aleghezzo/PCB-SiP-OSD3358-SM/README.txt

# 4 Layer PCB Based on SiP OSD3358-SM.
## Power Source - SMPS de 12/24V a 5V.
## LDO 3.3V.
## 2 USB Connectors: Host A y Device Micro B.
## MicroSD
