aleghezzo/PCB-SiP-OSD3358-SM/3D models/ST-TF-003A--3DModel-STEP-56544.STEP

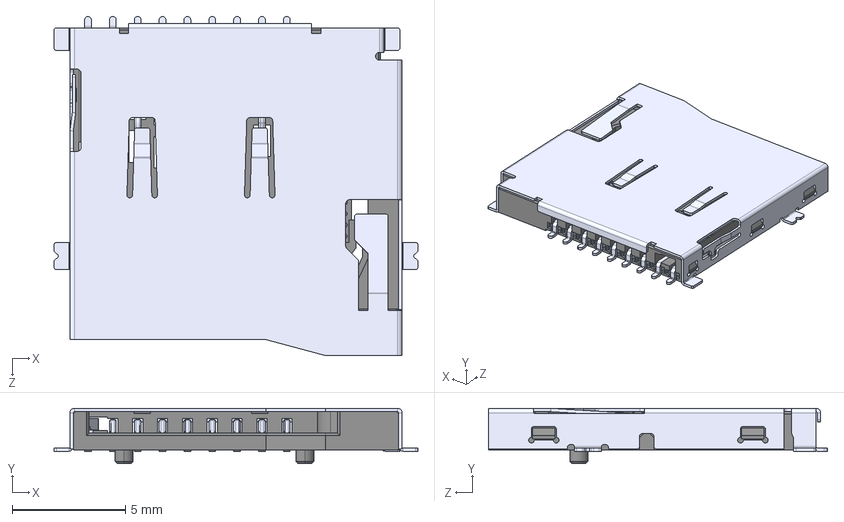
[picture p1: CAD file, 2020-08-16]
3D models/ST-TF-003A--3DModel-STEP-56544.STEP
16.1 x 2.45 x 15.0 mm
