aleghezzo/PCB-SiP-OSD3358-SM/3D models/microSD.stp

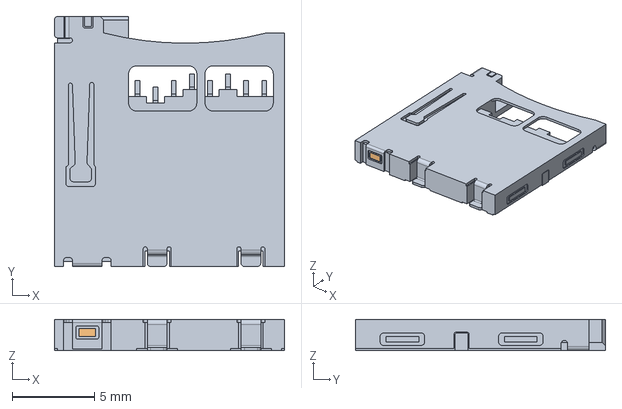
[picture p2: CAD file, 2020-08-06]
3D models/microSD.stp
14.0 x 15.2 x 1.90 mm
