aleghezzo/PCB-SiP-OSD3358-SM/3D models/CircuitWorks-FUSE.step

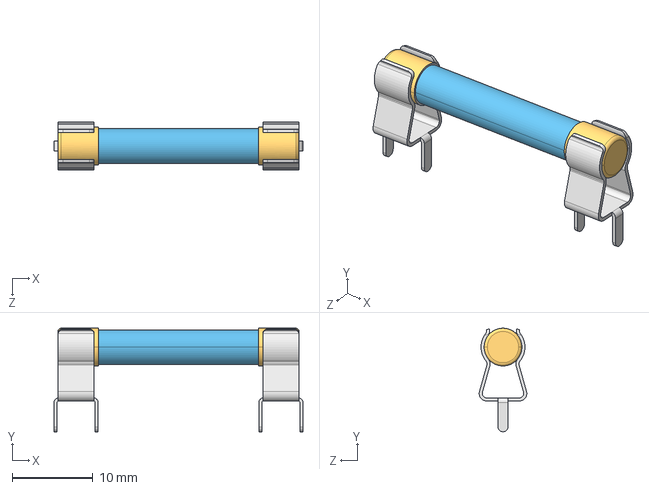
[picture p3: CAD file, 2020-08-06]
3D models/CircuitWorks-FUSE.step
30.9 x 12.8 x 5.90 mm
