aleghezzo/PCB-SiP-OSD3358-SM/3D models/0679H0250-01--3DModel-STEP-56544.STEP

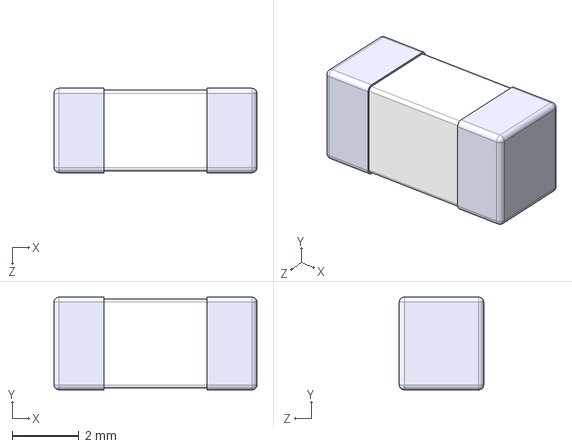
[picture p4: CAD file, 2020-08-16]
3D models/0679H0250-01--3DModel-STEP-56544.STEP
6.10 x 2.79 x 2.54 mm
