aleghezzo/PCB-SiP-OSD3358-SM/doc/pcbproyecto.pdf

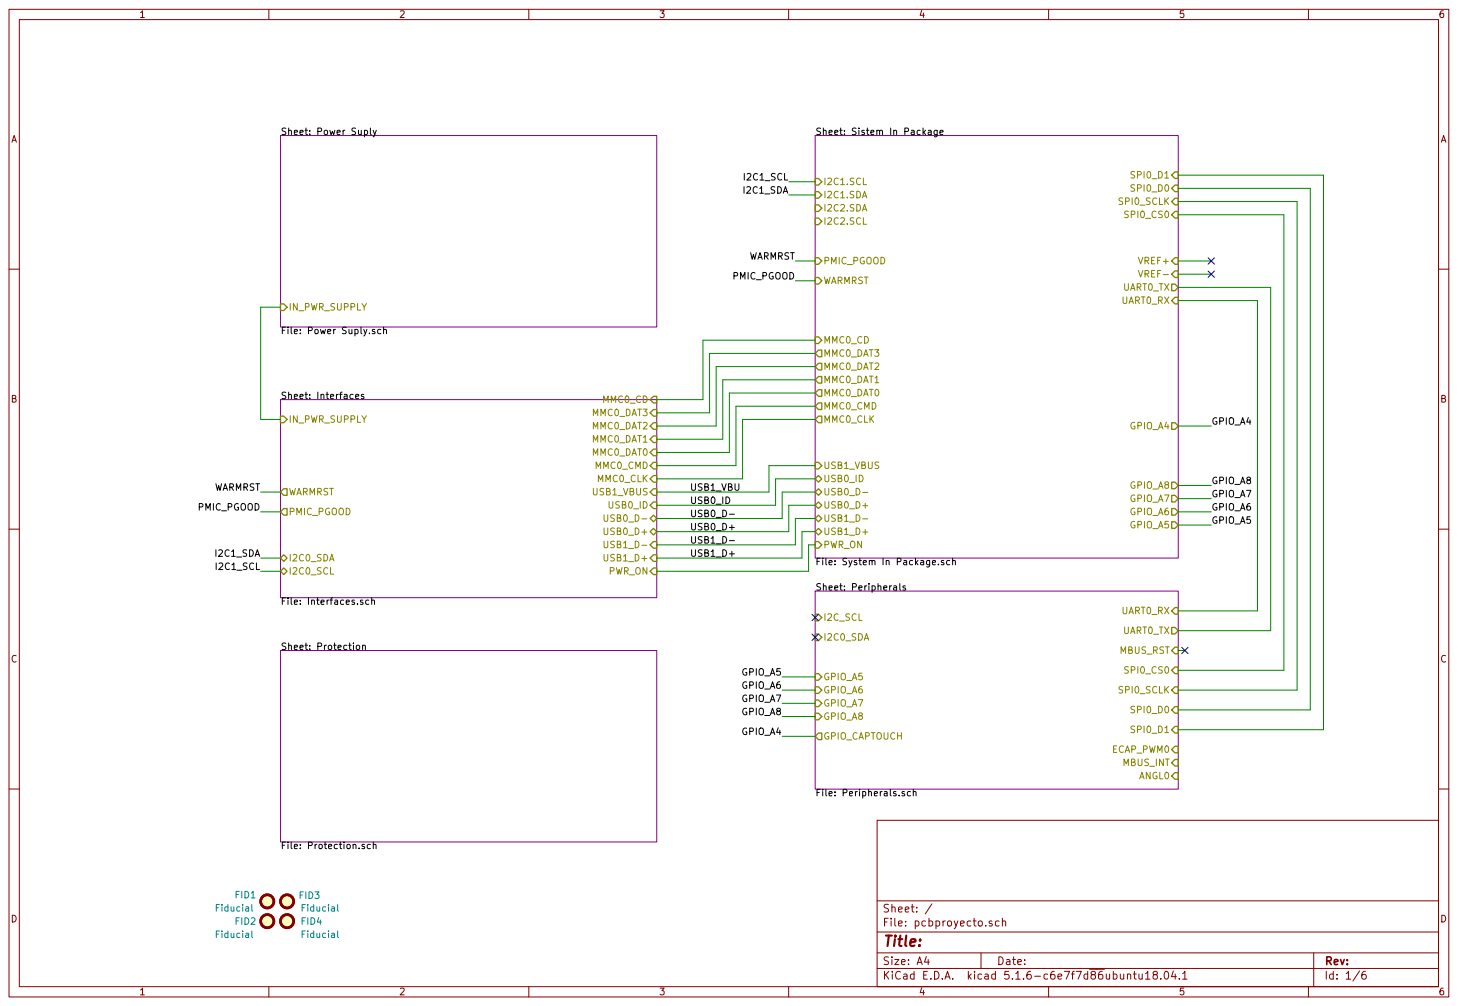
[picture p5: page 1]

Sheet: Sistem In Package
I2C2.SCL USB1_D- USB1_D+ USB0_D- USB0_D+ USB0_ID MMC0_CLK MMC0_DAT0 MMC0_DAT1 MMC0_DAT2 MMC0_DAT3 MMC0_CMD

File: Power Suply.sch

File: pcbproyecto.sch Sheet: / Sheet: Protection File: Protection.sch

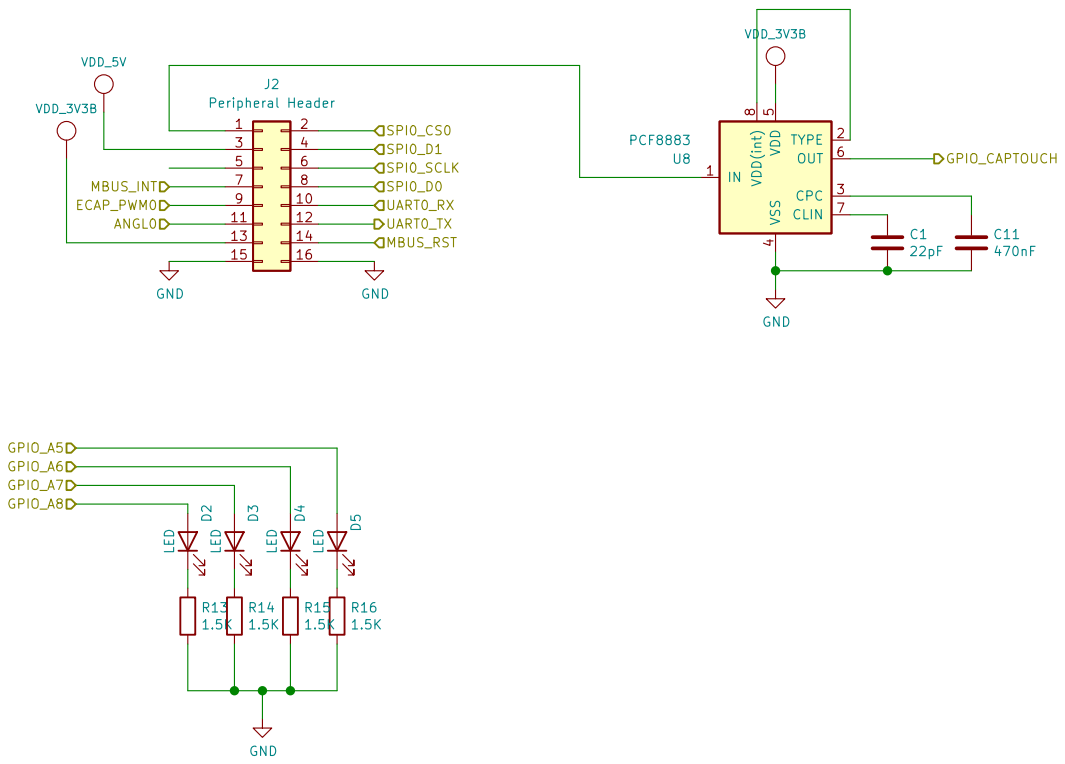
[picture p6: page 2]

5 OUT 6 CLIN 7 VDD(int) 8 U8 PCF8883

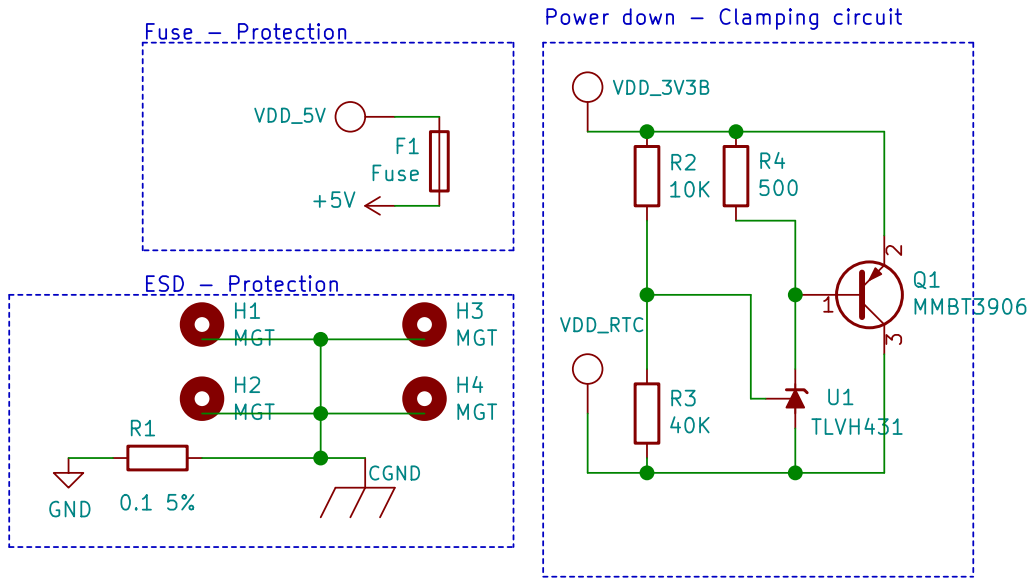
[picture p7: page 3]

2 3 Q1 H1 MMBT3906 MGT H3 MGT H2 MGT H4 MGT CGND R1

Id: 3/6 Title: File: Protection.sch Sheet: /Protection/

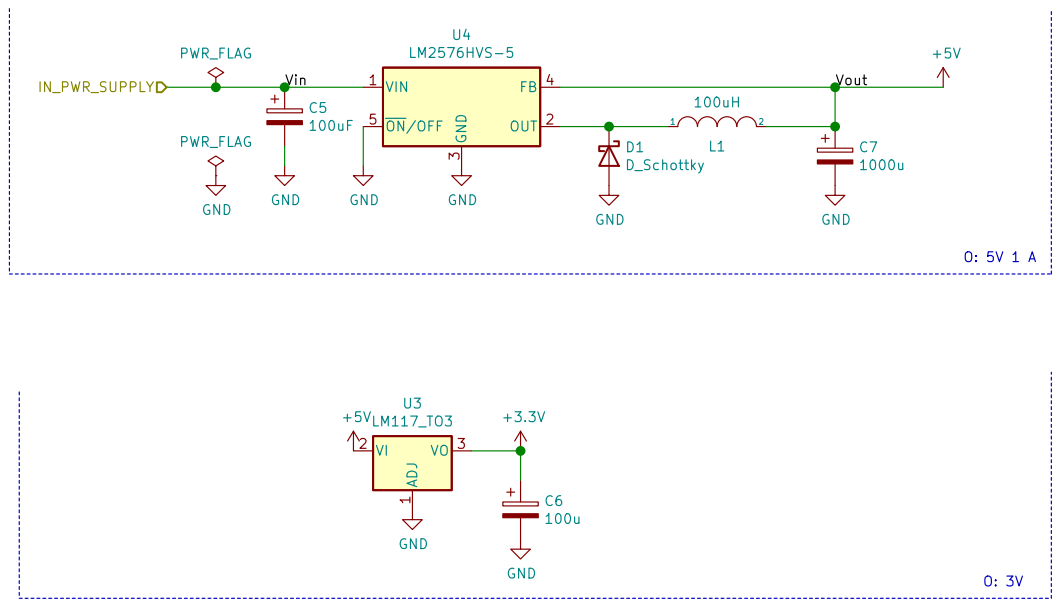
[picture p8: page 4]

Sheet: /Power Suply/
File: Power Suply.sch
Id: 4/6 Title:

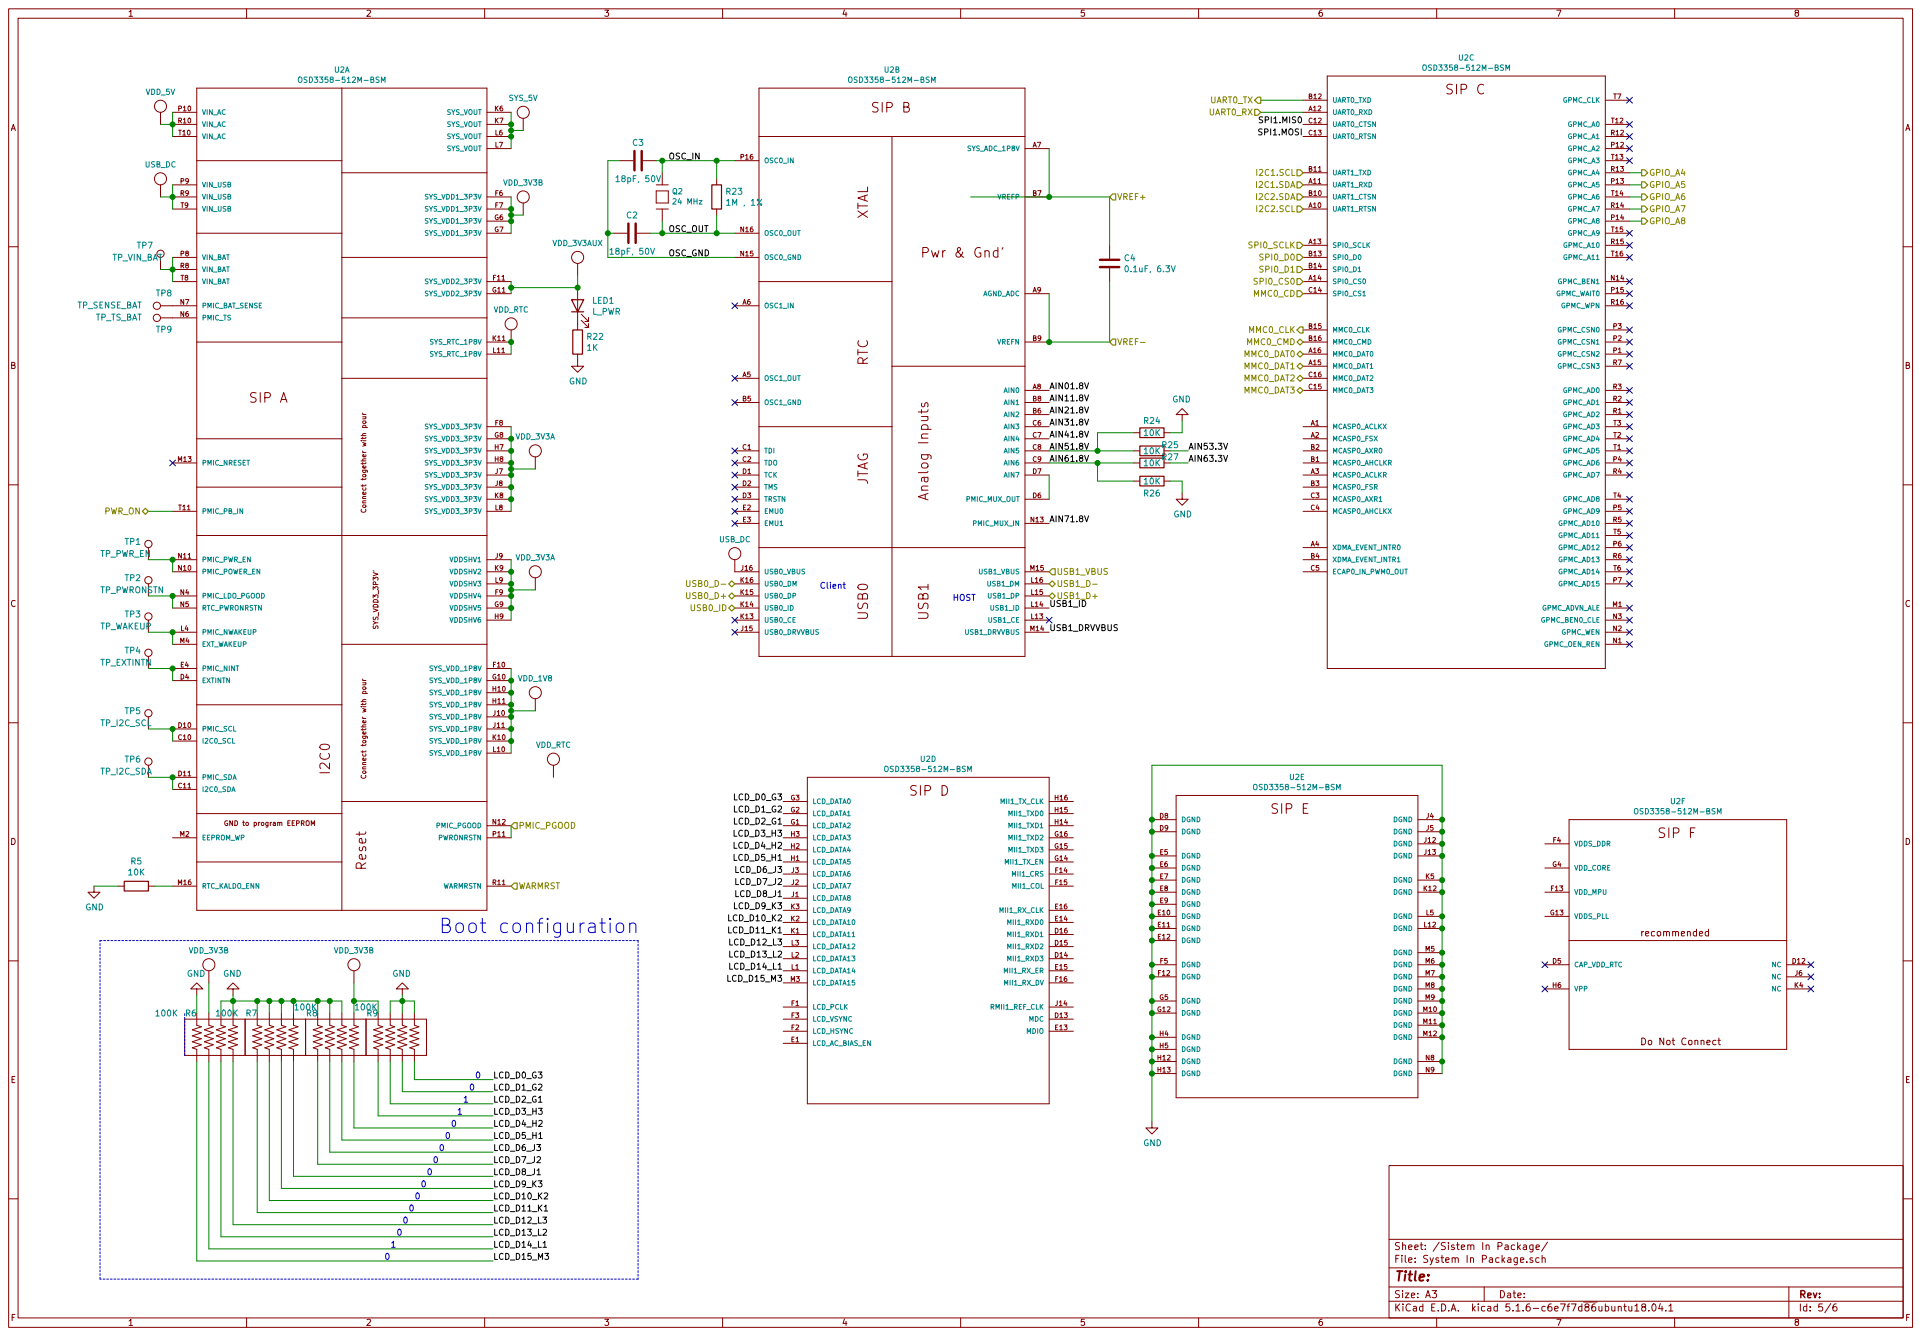
[picture p9: page 5]

Do Not Connect recommended SIP F

Sheet: /Sistem In Package/ GND

File: System In Package.sch
Id: 5/6 Title:

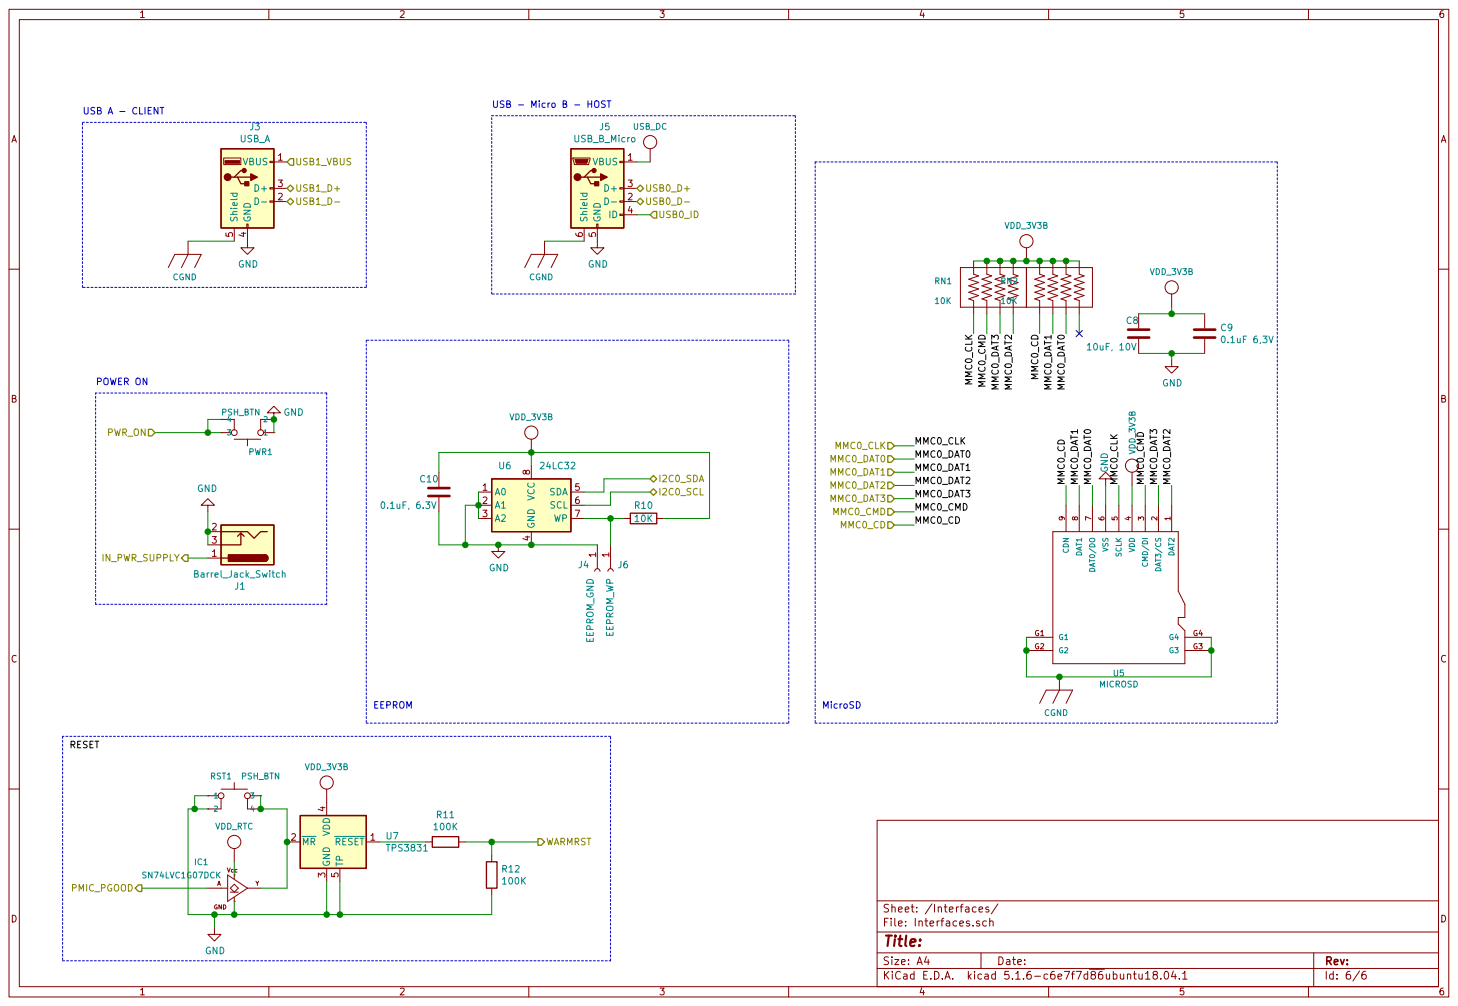
[picture p10: page 6]

USB A - CLIENT POWER ON
J1 Barrel_Jack_Switch CGND

4 SDA 5 SCL 6 WP 7 VCC

Id: 6/6 Title: File: Interfaces.sch Sheet: /Interfaces/
