aleghezzo/PCB-SiP-OSD3358-SM/doc/pcbproyecto-B_Cu.pdf

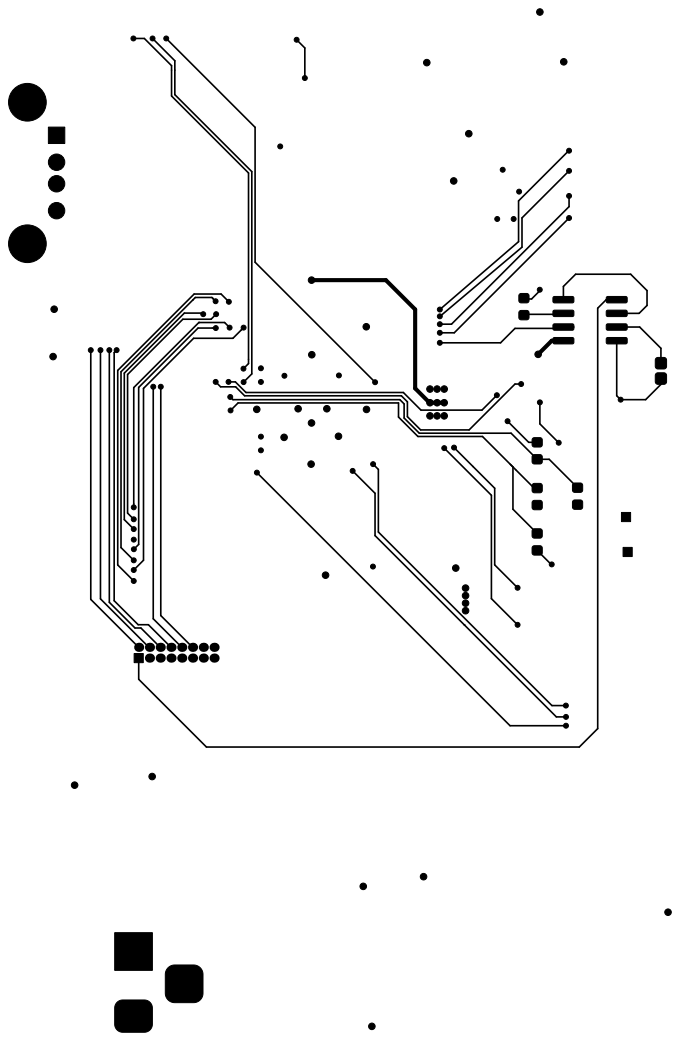
[picture p11: page 1]
