aleghezzo/PCB-SiP-OSD3358-SM/doc/pcbproyecto-B_Mask.pdf

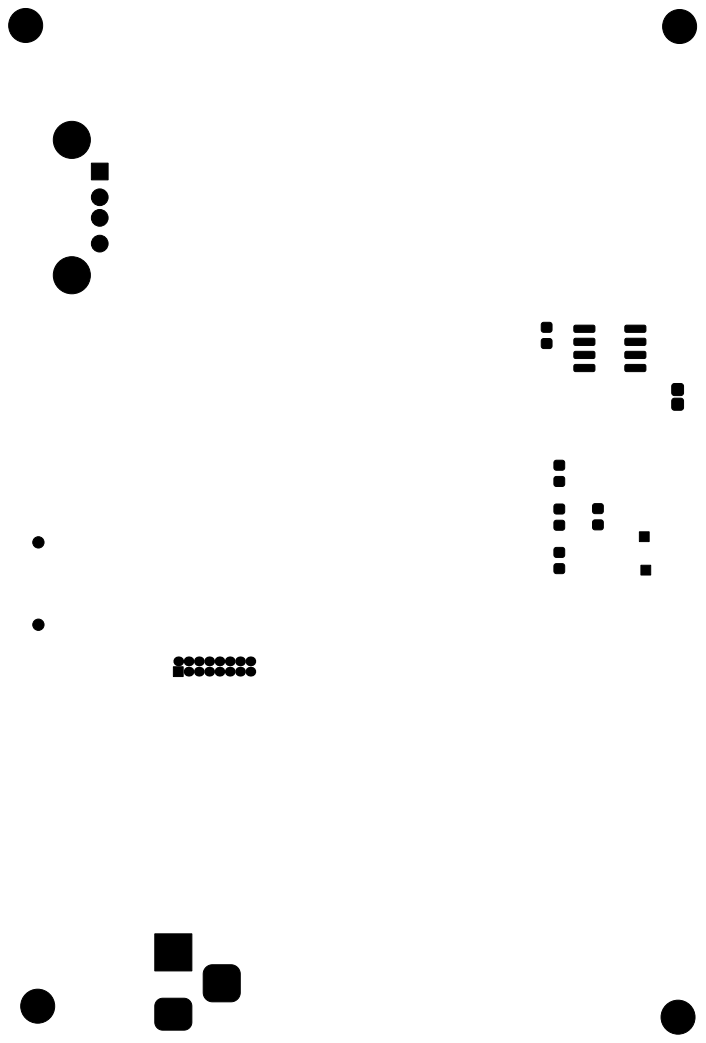
[picture p12: page 1]
