aleghezzo/PCB-SiP-OSD3358-SM/doc/pcbproyecto-B_Paste.pdf

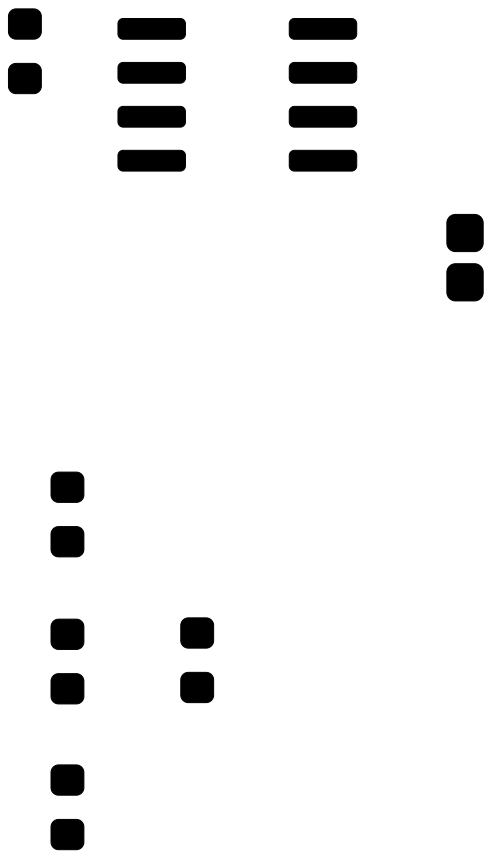
[picture p13: page 1]
