aleghezzo/PCB-SiP-OSD3358-SM/doc/pcbproyecto-B_SilkS.pdf

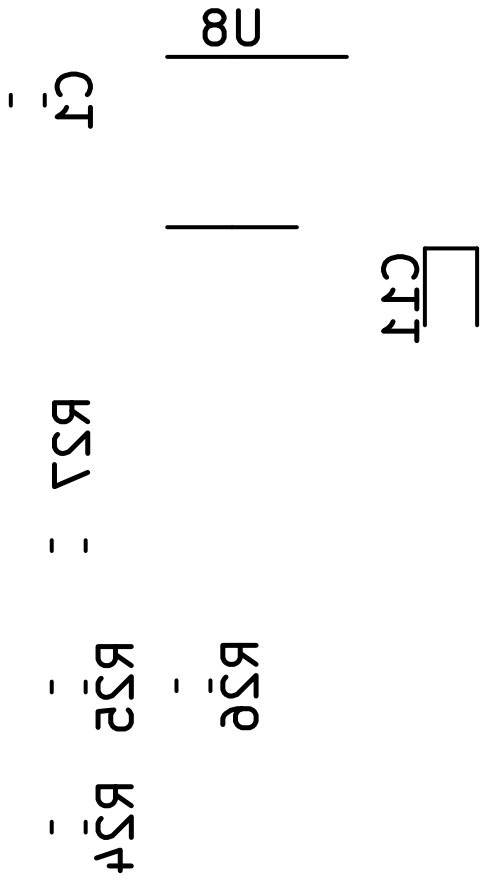
[picture p14: page 1]
