aleghezzo/PCB-SiP-OSD3358-SM/doc/pcbproyecto-Edge_Cuts.pdf

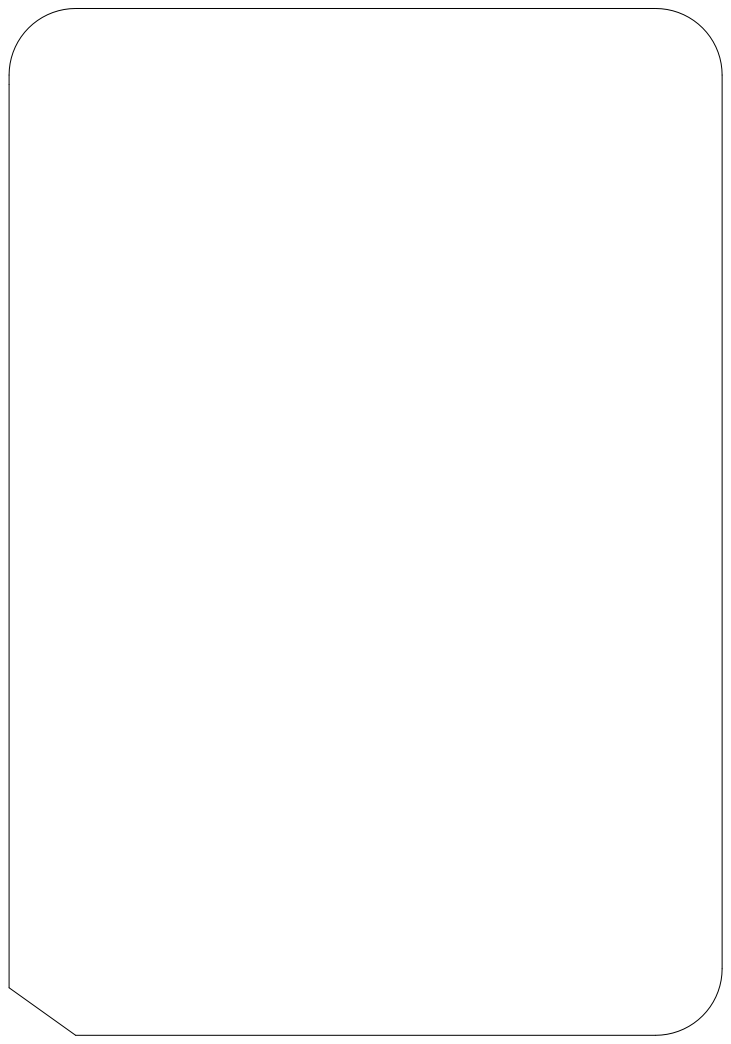
[picture p15: page 1]
