aleghezzo/PCB-SiP-OSD3358-SM/doc/pcbproyecto-F_Cu.pdf

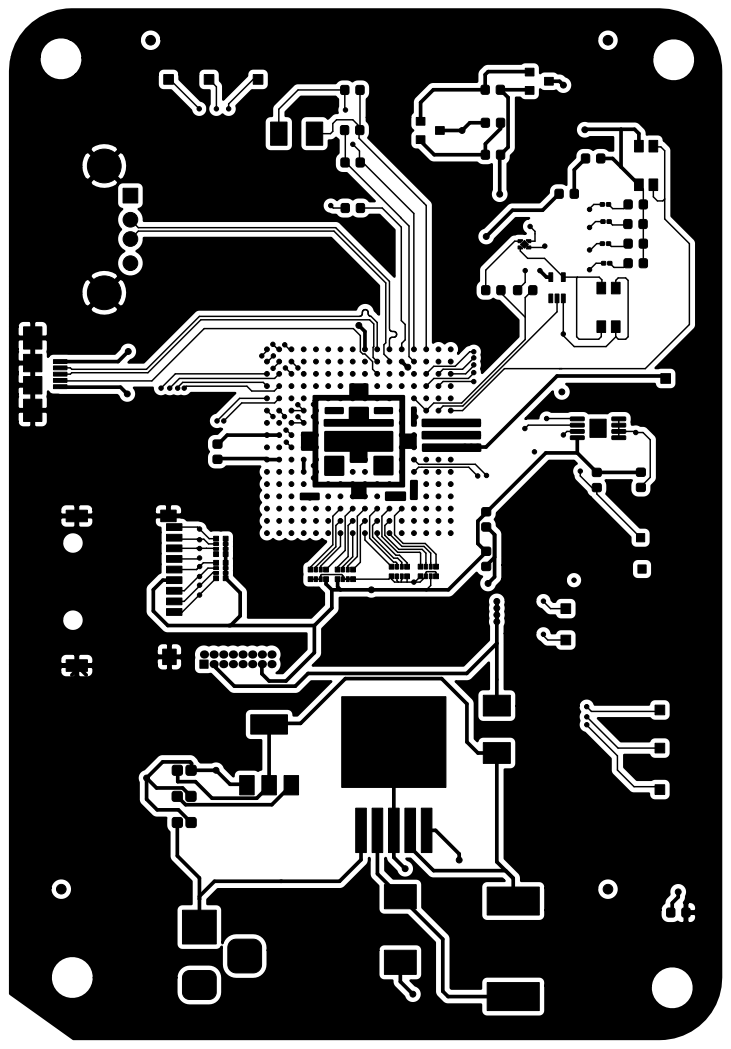
[picture p16: page 1]
