aleghezzo/PCB-SiP-OSD3358-SM/doc/pcbproyecto-F_Mask.pdf

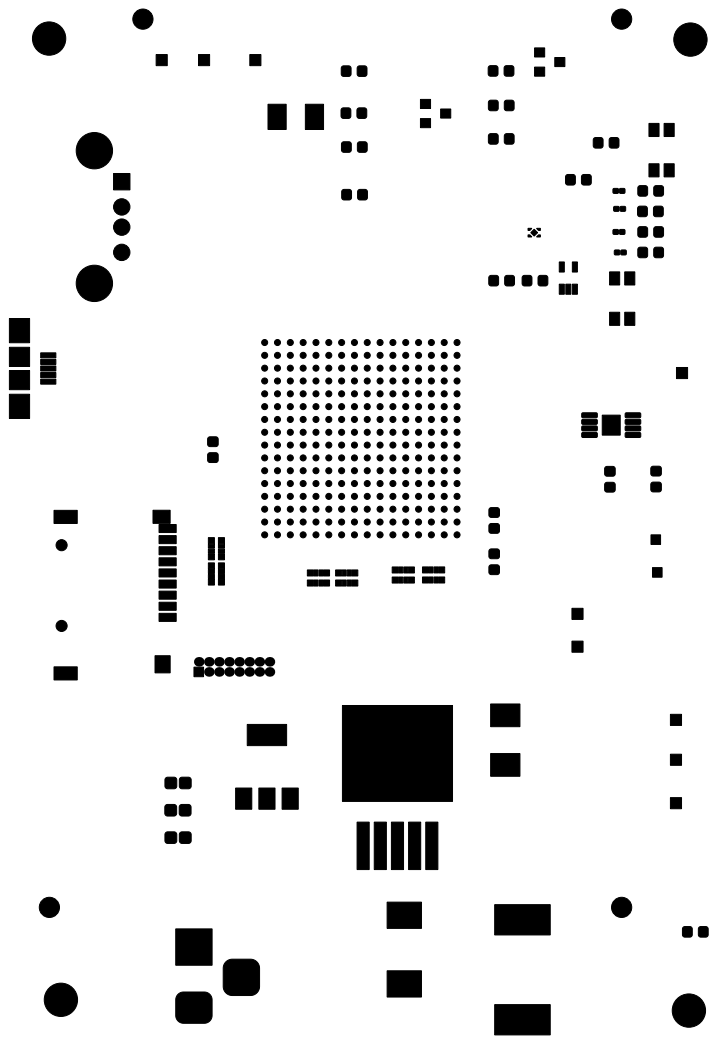
[picture p17: page 1]
