aleghezzo/PCB-SiP-OSD3358-SM/doc/pcbproyecto-F_Paste.pdf

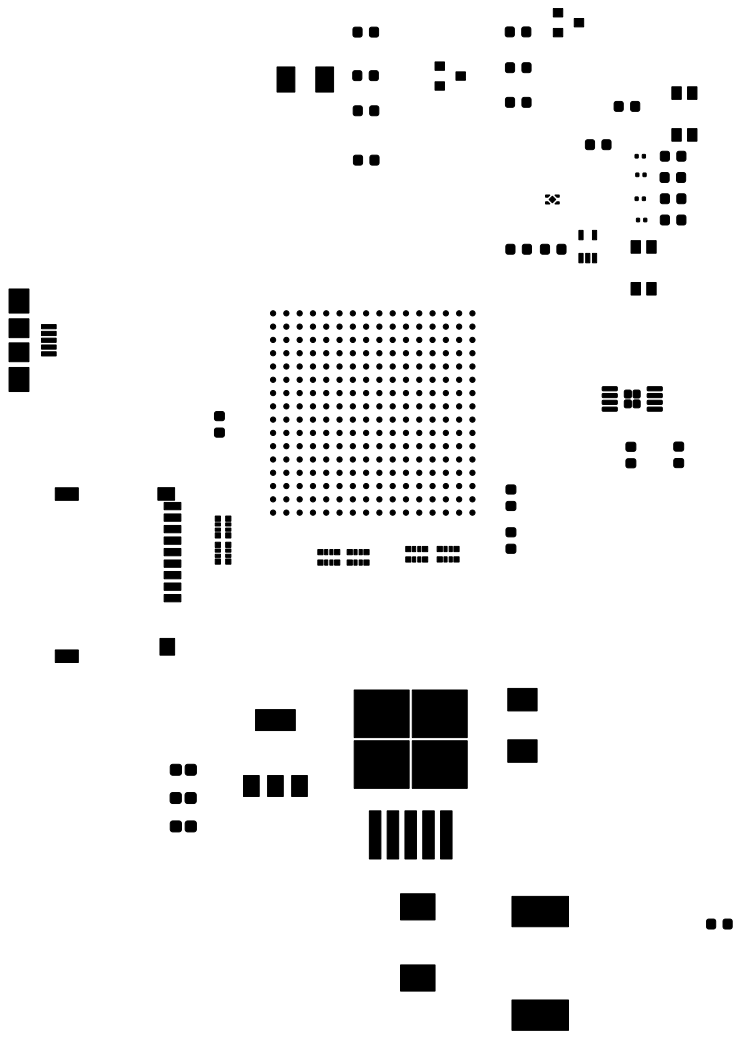
[picture p18: page 1]
