aleghezzo/PCB-SiP-OSD3358-SM/doc/pcbproyecto-F_SilkS.pdf

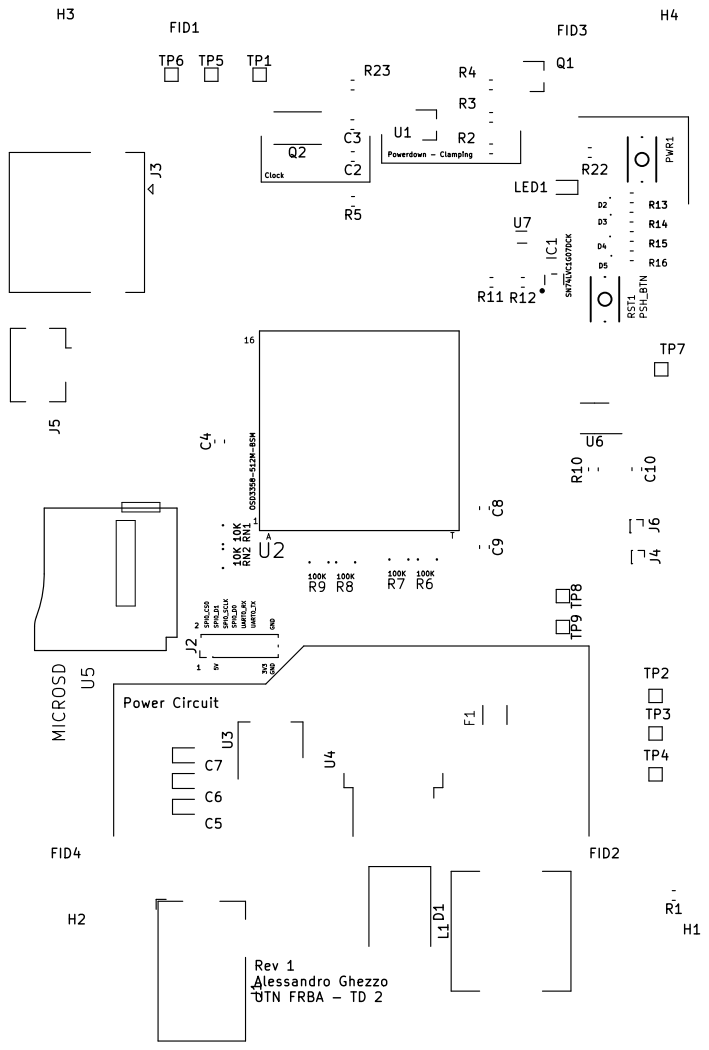
[picture p19: page 1]

Clock Rev 1 Alessandro Ghezzo UTN FRBA - TD 2
