aleghezzo/PCB-SiP-OSD3358-SM/doc/pcbproyecto-GND_Cu.pdf

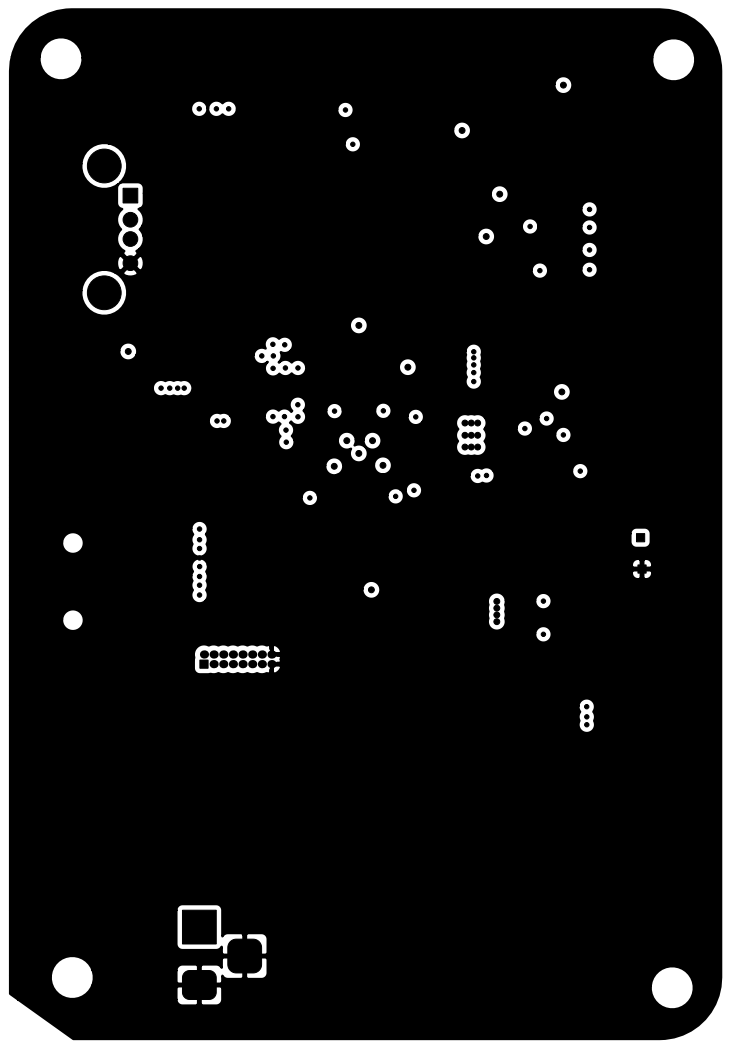
[picture p20: page 1]
