aleghezzo/PCB-SiP-OSD3358-SM/doc/pcbproyecto-Power_Cu.pdf

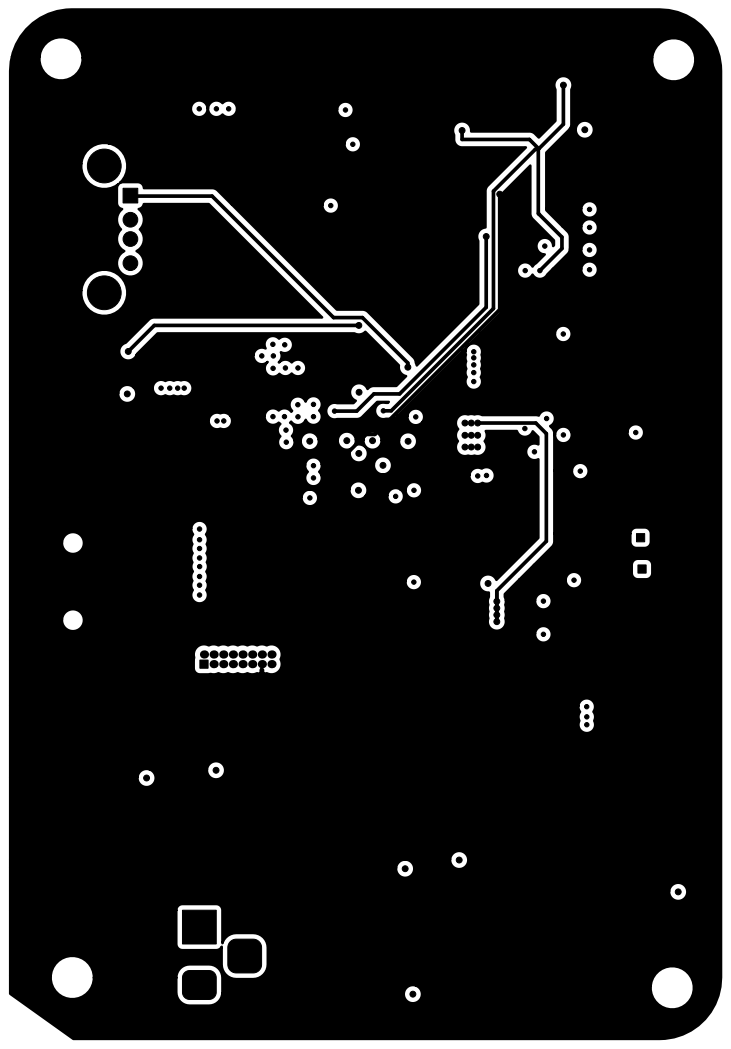
[picture p21: page 1]
