aleghezzo/PCB-SiP-OSD3358-SM/pcbproyecto.kicad_pcb

## KiCad design pcbproyecto.kicad_pcb (2020-08-16)

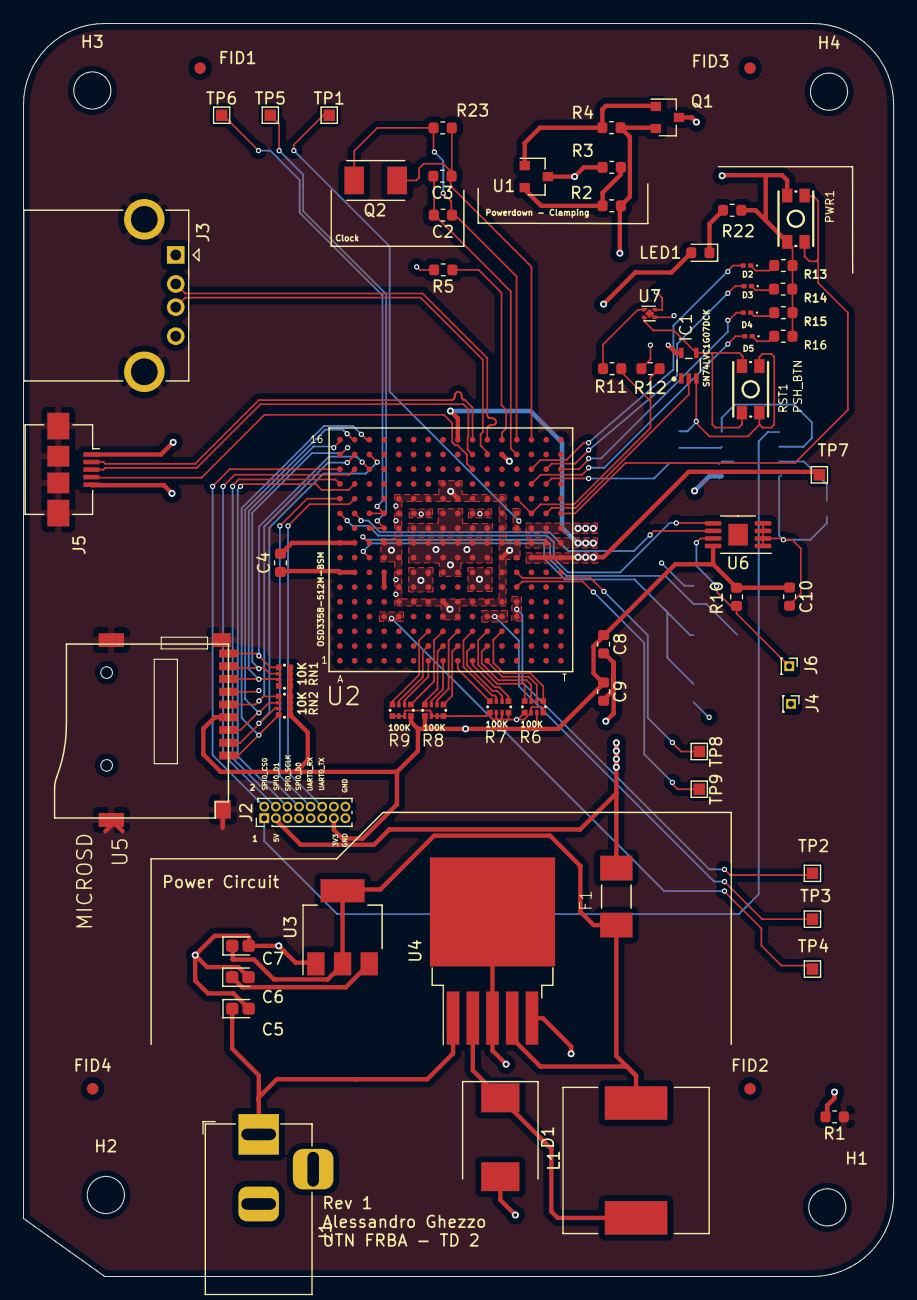
[picture p22: board pcbproyecto.kicad_pcb from above]

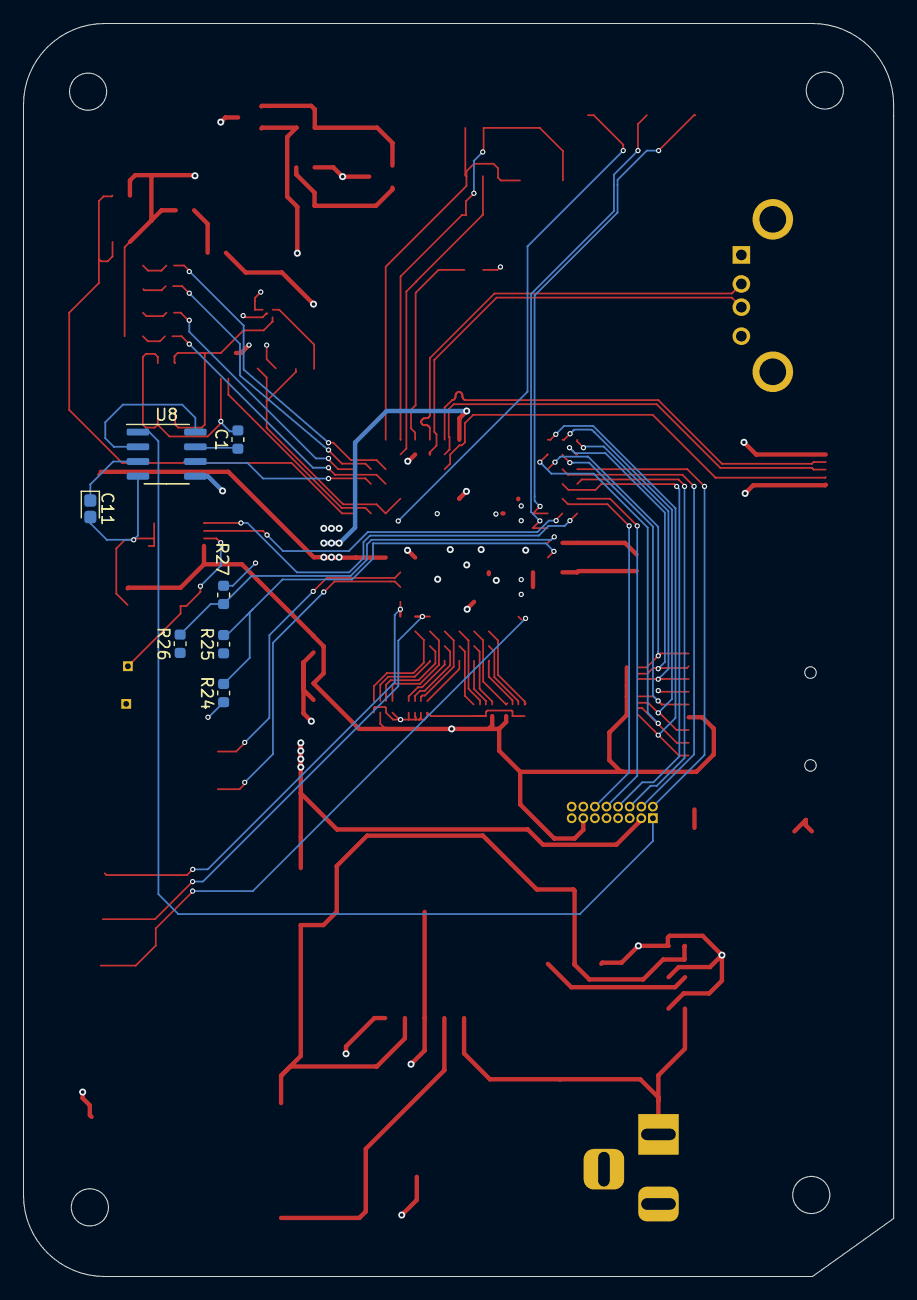
[picture p23: board pcbproyecto.kicad_pcb from below]

Board: 4 copper layers, 75.0 x 108.0 mm, 79 parts (7 on the bottom side), 91 nets.

Parts:
C1: 22pF; C_0603_1608Metric
C2, C3: 18pF, 50V; C_0603_1608Metric
C4, C10: 0.1uF, 6.3V; C_0603_1608Metric
C5: 100uF; CP_EIA-1608-08_AVX-J
C6: 100u; CP_EIA-1608-08_AVX-J
C7: 1000u; CP_EIA-1608-08_AVX-J
C8: 10uF, 10V; C_0603_1608Metric
C9: 0.1uF 6,3V; C_0603_1608Metric
C11: 470nF; CP_EIA-1608-08_AVX-J
D1: D_Schottky; D_SMC
D2, D3, D4, D5: LED; LED_0201_0603Metric
F1: Fuse; FUSC6125X279N
FID1, FID2, FID3, FID4: Fiducial; Fiducial_1mm_Mask2mm
H1, H2, H3, H4: MGT; MountingHole_3.2mm_M3
IC1: SN74LVC1G07DCK; SC70(TI-DCK)
J1: Barrel_Jack_Switch; BarrelJack_Horizontal
J2: Peripheral Header; PinHeader_2x08_P1.00mm_Vertical
J3: USB_A; USB_A_CONNFLY_DS1095-WNR0
J4: EEPROM_GND; PinHeader_1x01_P1.00mm_Vertical
J5: USB_B_Micro; USB_Micro-B_Amphenol_10104110_Horizontal
J6: EEPROM_WP; PinHeader_1x01_P1.00mm_Vertical
L1: 100uH; L_12x12mm_H6mm
LED1: L_PWR; LED_0603_1608Metric
PWR1: PSH_BTN; MINI_PUSHBUTTON
Q1: MMBT3906; SOT-23
Q2: 24 MHz; Crystal_SMD_TXC_7A-2Pin_5x3.2mm
R1: 0.1 5%; R_0603_1608Metric
R2, R5, R10, R24, R25, R26, R27: 10K; R_0603_1608Metric
R3: 40K; R_0603_1608Metric
R4: 500; R_0603_1608Metric
R6, R7, R8, R9: 100K; RN0804
R11, R12: 100K; R_0603_1608Metric
R13, R14, R15, R16: 1.5K; R_0603_1608Metric
R22: 1K; R_0603_1608Metric
R23: 1M , 1%; R_0603_1608Metric
RN1, RN2: 10K; RN0804
RST1: PSH_BTN; MINI_PUSHBUTTON
TP1: TP_PWR_EN; TestPoint_Pad_1.0x1.0mm
TP2: TP_PWRONSTN; TestPoint_Pad_1.0x1.0mm
TP3: TP_WAKEUP; TestPoint_Pad_1.0x1.0mm
TP4: TP_EXTINTN; TestPoint_Pad_1.0x1.0mm
TP5: TP_I2C_SCL; TestPoint_Pad_1.0x1.0mm
TP6: TP_I2C_SDA; TestPoint_Pad_1.0x1.0mm
TP7: TP_VIN_BAT; TestPoint_Pad_1.0x1.0mm
TP8: TP_SENSE_BAT; TestPoint_Pad_1.0x1.0mm
TP9: TP_TS_BAT; TestPoint_Pad_1.0x1.0mm
U1: TLVH431; SOT-23
U2: OSD3358-512M-BSM; OSD335X-BGA-256
U3: LM117_TO3; SOT-223-3_TabPin2
U4: LM2576HVS-5; TO-263-5_TabPin3
U5: MICROSD
U6: 24LC32; MSOP-8-1EP_3x3mm_P0.65mm_EP1.68x1.88mm
U7: TPS3831; Texas_X2SON-4_1x1mm_P0.65mm
U8: PCF8883; SOIC-8_3.9x4.9mm_P1.27mm

Connections:
+3V3: C6.1, U3.3
+5V: C7.1, F1.1, L1.2, U3.2, U4.4
/GPIO_A4: U2.R13, U8.6
/GPIO_A5: D5.2, U2.P13
/GPIO_A6: D4.2, U2.T14
/GPIO_A7: D3.2, U2.R14
/GPIO_A8: D2.2, U2.P14
/I2C1_SCL: U2.B11, U6.6
/I2C1_SDA: U2.A11, U6.5
/Interfaces/IN_PWR_SUPPLY: C5.1, J1.1, U4.1
/Interfaces/MMC0_CD: RN2.5, U2.C14, U5.9
/Interfaces/MMC0_CLK: RN1.5, U2.B15, U5.5
/Interfaces/MMC0_CMD: RN1.6, U2.B16, U5.3
/Interfaces/MMC0_DAT0: RN2.7, U2.A16, U5.7
/Interfaces/MMC0_DAT1: RN2.6, U2.A15, U5.8
/Interfaces/MMC0_DAT2: RN1.8, U2.C16, U5.1
/Interfaces/MMC0_DAT3: RN1.7, U2.C15, U5.2
/Interfaces/PWR_ON: PWR1.3, PWR1.4, U2.T11
/PMIC_PGOOD: IC1.2, U2.R11
/Peripherals/SPI0_CS0: J2.2, U2.A14
/Peripherals/SPI0_D0: J2.8, U2.B13
/Peripherals/SPI0_D1: J2.4, U2.B14
/Peripherals/SPI0_SCLK: J2.6, U2.A13
/Peripherals/UART0_RX: J2.10, U2.A12
/Peripherals/UART0_TX: J2.12, U2.B12
/Sistem In Package/AIN51.8V: R24.2, R25.2, U2.C8
/Sistem In Package/AIN61.8V: R26.2, R27.2, U2.C9
/Sistem In Package/LCD_D0_G3: R9.8, U2.G3
/Sistem In Package/LCD_D1_G2: R9.7, U2.G2
/Sistem In Package/LCD_D2_G1: R9.6, U2.G1
/Sistem In Package/LCD_D3_H3: R9.5, U2.H3
/Sistem In Package/LCD_D4_H2: R8.8, U2.H2
/Sistem In Package/LCD_D5_H1: R8.7, U2.H1
/Sistem In Package/LCD_D6_J3: R8.6, U2.J3
/Sistem In Package/LCD_D7_J2: R8.5, U2.J2
/Sistem In Package/LCD_D8_J1: R7.8, U2.J1
/Sistem In Package/LCD_D9_K3: R7.7, U2.K3
/Sistem In Package/LCD_D10_K2: R7.6, U2.K2
/Sistem In Package/LCD_D11_K1: R7.5, U2.K1
/Sistem In Package/LCD_D12_L3: R6.8, U2.L3
/Sistem In Package/LCD_D13_L2: R6.7, U2.L2
/Sistem In Package/LCD_D14_L1: R6.6, U2.L1
/Sistem In Package/LCD_D15_M3: R6.5, U2.M3
/Sistem In Package/OSC_GND: C2.2, C3.2, U2.N15
/Sistem In Package/OSC_IN: C3.1, Q2.2, R23.1, U2.P16
/Sistem In Package/OSC_OUT: C2.1, Q2.1, R23.2, U2.N16
/Sistem In Package/VREF+: C4.1, U2.A7, U2.B7
/Sistem In Package/VREF-: C4.2, U2.A9, U2.B9
/USB0_D+: J5.3, U2.K15
/USB0_D-: J5.2, U2.K16
/USB0_ID: J5.4, U2.K14
/USB1_D+: J3.3, U2.L15
/USB1_D-: J3.2, U2.L16
/USB1_VBU: J3.1, U2.M15
/WARMRST: R11.1, R12.1, U2.N12, U2.P11
CGND: J3.5, J5.6, R1.1, U5.G1, U5.G2, U5.G3, U5.G4
GND: C1.2, C5.2, C6.2, C7.2, C8.2, C9.2, C10.2, C11.2, D1.2, IC1.3, J1.2, J1.3, J2.15, J2.16, J3.4, J4.1, J5.5, PWR1.1, PWR1.2, R1.2, R5.2, R6.1, R6.2, R6.4, R7.1, R7.2, R7.3, R7.4, R8.2, R8.3, R8.4, R9.1, R9.2, R9.3, R12.2, R13.2, R14.2, R15.2, R16.2, R22.2, R24.1, R27.1, RST1.1, RST1.2, U2.D8, U2.D9, U2.E5, U2.E6, U2.E7, U2.E8, U2.E9, U2.E10, U2.E11, U2.E12, U2.F5, U2.F12, U2.G5, U2.G12, U2.H4, U2.H5, U2.H12, U2.H13, U2.J4, U2.J5, U2.J12, U2.J13, U2.K5, U2.K12, U2.L5, U2.L12, U2.M5, U2.M6, U2.M7, U2.M8, U2.M9, U2.M10, U2.M11, U2.M12, U2.N8, U2.N9, U3.1, U4.3, U4.5, U5.6, U6.1, U6.2, U6.3, U6.4, U7.3, U7.5, U8.4
unnamed: C1.1, U8.7
unnamed: C11.1, U8.3
unnamed: D1.1, L1.1, U4.2
unnamed: D2.1, R13.1
unnamed: D3.1, R14.1
unnamed: D4.1, R15.1
unnamed: D5.1, R16.1
unnamed: IC1.4, RST1.3, RST1.4, U7.2
unnamed: J2.1, U8.1
unnamed: J6.1, R10.2, U6.7
unnamed: LED1.1, R22.1
unnamed: Q1.1, R4.1, U1.1
unnamed: R2.2, R3.2, U1.2
unnamed: R5.1, U2.M16
unnamed: R11.2, U7.1
unnamed: TP1.1, U2.N10, U2.N11
unnamed: TP2.1, U2.N4, U2.N5
unnamed: TP3.1, U2.L4, U2.M4
unnamed: TP4.1, U2.D4, U2.E4
unnamed: TP5.1, U2.C10, U2.D10
unnamed: TP6.1, U2.C11, U2.D11
unnamed: TP7.1, U2.P8, U2.R8, U2.T8
unnamed: TP8.1, U2.N7
unnamed: TP9.1, U2.N6
unnamed: U2.D6, U2.D7
unnamed: U8.2, U8.8
SYS_5V: U2.K6, U2.K7, U2.L6, U2.L7
USB_DC: J5.1, U2.J16, U2.P9, U2.R9, U2.T9
VDD_1V8: U2.F10, U2.G10, U2.H10, U2.H11, U2.J10, U2.J11, U2.K10, U2.L10
VDD_3V3A: U2.F8, U2.F9, U2.G8, U2.G9, U2.H7, U2.H8, U2.H9, U2.J7, U2.J8, U2.J9, U2.K8, U2.K9, U2.L8, U2.L9
VDD_3V3AUX: LED1.2, U2.F11, U2.G11
VDD_3V3B: C8.1, C9.1, C10.1, J2.13, Q1.2, R2.1, R4.2, R6.3, R8.1, R9.4, R10.1, RN1.1, RN1.2, RN1.3, RN1.4, RN2.1, RN2.2, RN2.3, RN2.4, U2.F6, U2.F7, U2.G6, U2.G7, U5.4, U6.8, U7.4, U8.5
VDD_5V: F1.2, J2.3, U2.P10, U2.R10, U2.T10
VDD_RTC: IC1.5, Q1.3, R3.1, U1.3, U2.K11, U2.L11
