aleghezzo/PCB-SiP-OSD3358-SM/(commit log)

2020-07-31 EMD Protection
    [pcbproyecto.kicad_pcb]
2020-08-03 Progress - No custom peripheral
    [Peripherals.sch, System In Package.sch, pcbproyecto.kicad_pcb, pcbproyecto.sch]
2020-08-05 WIP - Docs & Gerbers (no custom peripheric yet)
    [Interfaces.sch, Peripherals.sch, System In Package.sch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]
2020-08-06 Custom Peripheral, Gerbers, drills
    [Peripherals.sch, System In Package.sch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]
2020-08-06 Bill of Materials + Some 3D Models
    [CircuitWorks-FUSE.step, Protection.sch, bill.ods, microSD.stp, pcbproyecto.kicad_pcb]
2020-08-09 Checklist & Small changes, new docs & gerbers
    [PCB Layout Checklist.xlsx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]
2020-08-16 DRC Fixes and more
    [0679H0250-01--3DModel-STEP-56544.STEP, Interfaces.sch, Peripherals.sch, Protection.sch, ST-TF-003A--3DModel-STEP-56544.STEP, System In Package.sch, autogenerated_bom_donottakeintoaccount.csv, bill.ods]
